joeycastillo/SAMD11_Feathers/OSO-SAFE-A1-04.brd

## EAGLE design OSO-SAFE-A1-04.brd (2023-04-11)

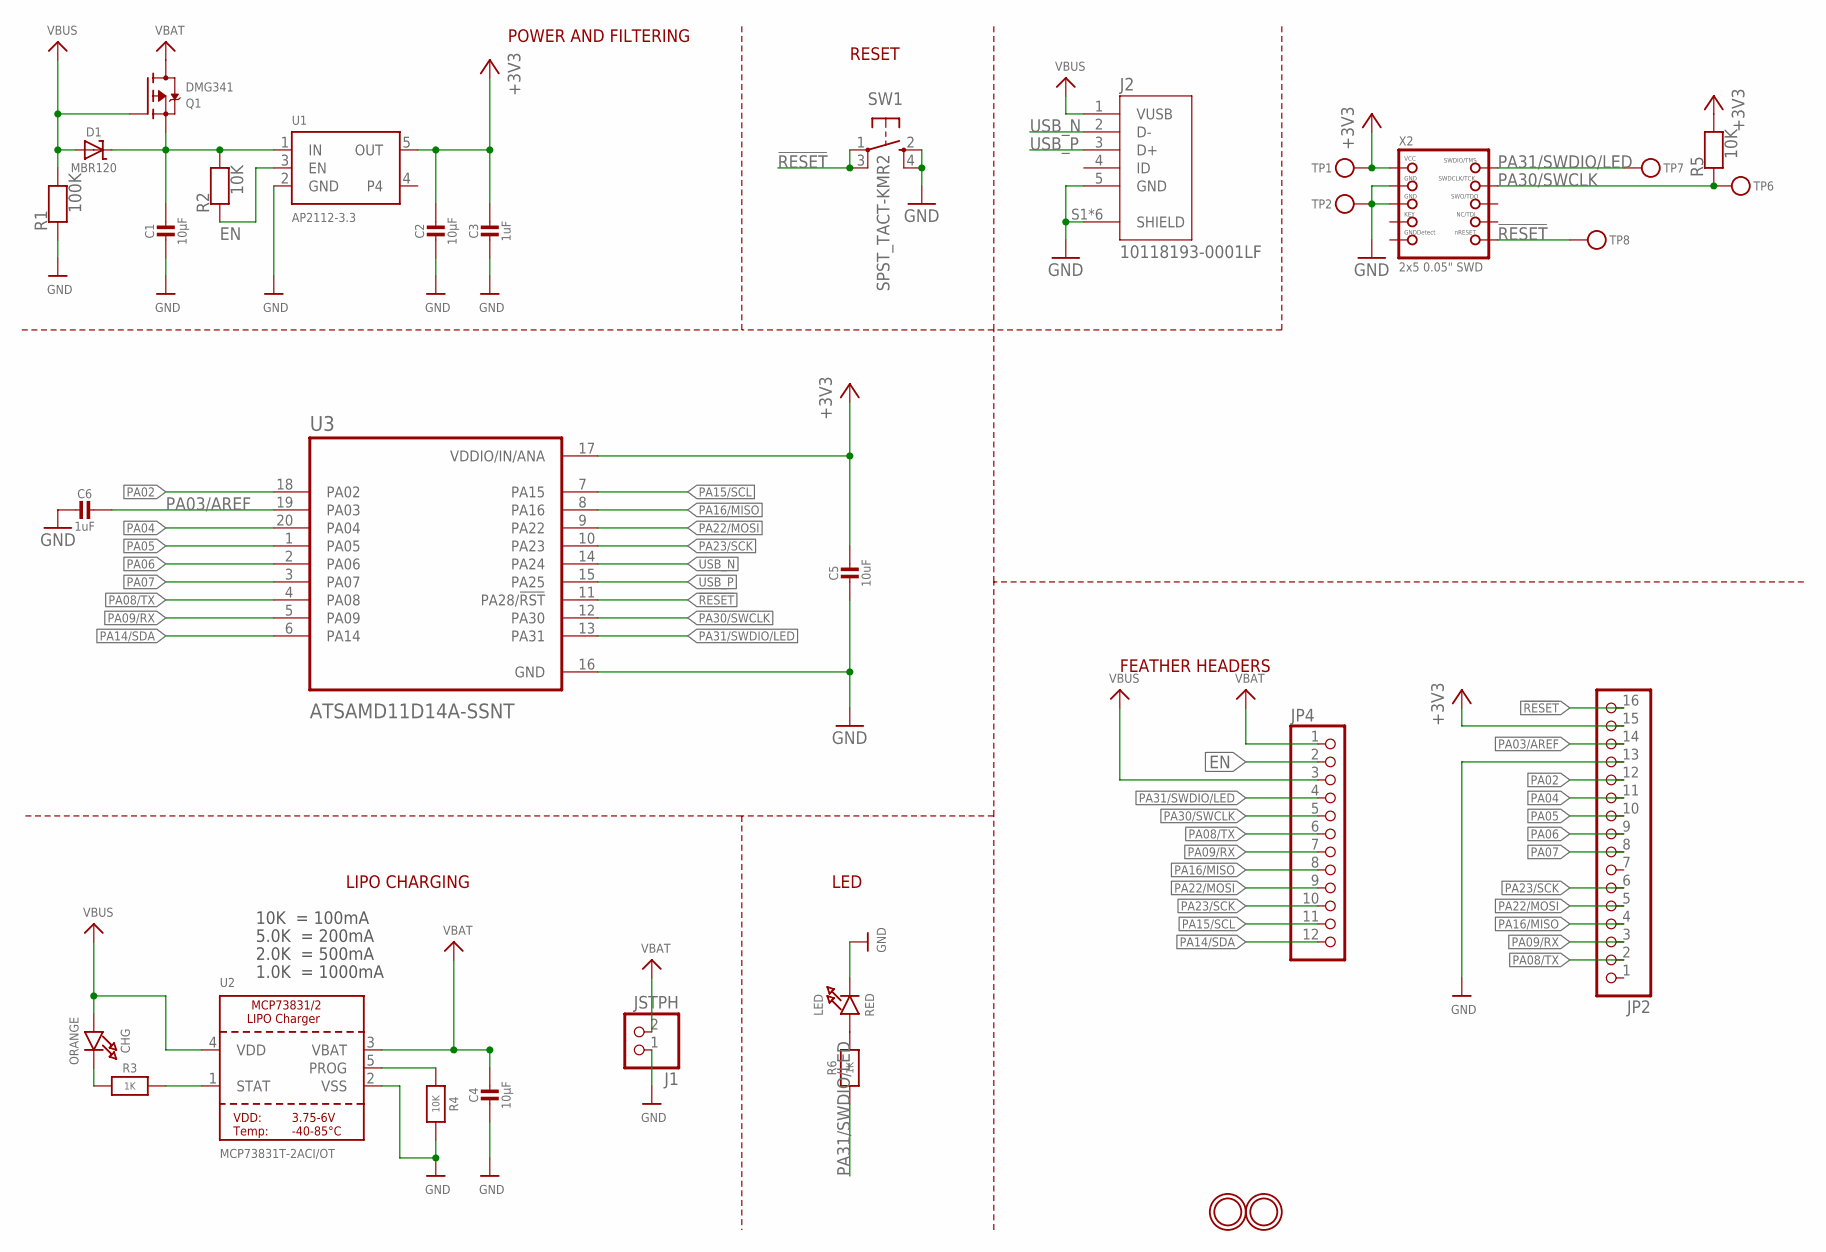
[picture p1: schematic OSO-SAFE-A1-04.sch]

Parts:
C1, C2, C4: 10µF; 0805-NO
C3, C6: 1uF; 0805-NO
C5: 10uF; 0805-NO
CHG: ORANGE; CHIPLED_0805_NOOUTLINE
D1: MBR120; SOD-123
J1: JSTPH; JSTPH2
J2: 10118193-0001LF; FCI_10118193-0001LF
JP2: HEADER-1X16_MIN; 1X16_ROUND_MIN
JP4: HEADER-1X12_MIN; 1X12_ROUND_MIN
LED: RED; CHIPLED_0805_NOOUTLINE
Q1: DMG341; SOT23-R
R1: 100K; 0805-NO
R2, R4, R5: 10K; 0805-NO
R3, R6: 1K; 0805-NO
SW1: SPST_TACT-KMR2; KMR2
TP1, TP2, TP6, TP7, TP8: TESTPOINTROUND2MMNO; TESTPOINT_ROUND_2MM_NO
U1: AP2112-3.3; SOT23-5
U2: MCP73831T-2ACI/OT; SOT23-5
U3: ATSAMD11D14A-SSNT; SOIC127P1030X265-20N
U$31, U$32: MOUNTINGHOLE2.5; MOUNTINGHOLE_2.5_PLATED
X2: 2x5 0.05" SWD; 2X05_1.27MM_BOX_NOPOSTS

Connections:
!RESET: JP2.16, SW1.1, SW1.3 (P1), TP8.P$1, U3.11 (PA28/!RST), X2.10 (NRESET)
+3V3: C2.1, C3.1, C5.1, JP2.15, R5.2, TP1.P$1, U1.5 (OUT), U3.17 (VDDIO/IN/ANA), X2.1 (VCC)
CHG: CHG.C, R3.1
EN: JP4.2, R2.1, U1.3 (EN)
GND: C1.2, C2.2, C3.2, C4.2, C5.2, C6.2, J1.1, J2.5 (GND), J2.S1 (SHIELD), J2.S2 (SHIELD), J2.S3 (SHIELD), J2.S4 (SHIELD), J2.S5 (SHIELD), J2.S6 (SHIELD), JP2.13, LED.C, R1.1, R4.2, SW1.2 (S), SW1.4 (S1), TP2.P$1, U1.2 (GND), U2.2 (VSS), U3.16 (GND), X2.3 (GND), X2.5 (GND)
unnamed: LED.A, R6.2
PA02: JP2.12, U3.18 (PA02)
PA03/AREF: C6.1, JP2.14, U3.19 (PA03)
PA04: JP2.11, U3.20 (PA04)
PA05: JP2.10, U3.1 (PA05)
PA06: JP2.9, U3.2 (PA06)
PA07: JP2.8, U3.3 (PA07)
PA08/TX: JP2.2, JP4.6, U3.4 (PA08)
PA09/RX: JP2.3, JP4.7, U3.5 (PA09)
PA14/SDA: JP4.12, U3.6 (PA14)
PA15/SCL: JP4.11, U3.7 (PA15)
PA16/MISO: JP2.4, JP4.8, U3.8 (PA16)
PA22/MOSI: JP2.5, JP4.9, U3.9 (PA22)
PA23/SCK: JP2.6, JP4.10, U3.10 (PA23)
PA30/SWCLK: JP4.5, R5.1, TP6.P$1, U3.12 (PA30), X2.4 (SWDCLK)
PA31/SWDIO/LED: JP4.4, R6.1, TP7.P$1, U3.13 (PA31), X2.2 (SWDIO)
PROG: R4.1, U2.5 (PROG)
STAT: R3.2, U2.1 (STAT)
USB_N: J2.2 (D-), U3.14 (PA24)
USB_P: J2.3 (D+), U3.15 (PA25)
VBAT: C4.1, J1.2, JP4.1, Q1.3 (D), U2.3 (VBAT)
VBUS: CHG.A, D1.A, J2.1 (VUSB), JP4.3, Q1.1 (G), R1.2, U2.4 (VDD)
VHI: C1.1, D1.C, Q1.2 (S), R2.2, U1.1 (IN)

Notes on the sheet:
LIPO CHARGING
LED
RESET
POWER AND FILTERING
10K = 100mA
5.0K = 200mA
2.0K = 500mA
1.0K = 1000mA
FEATHER HEADERS

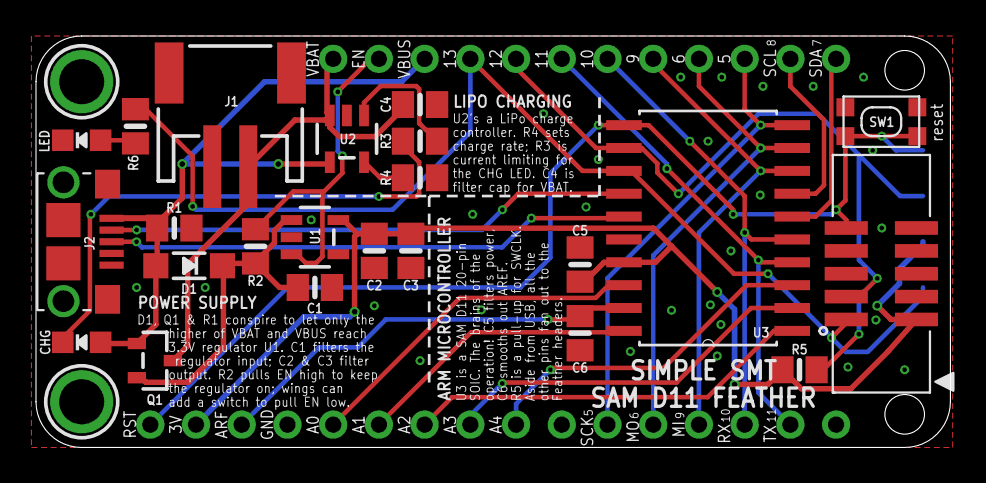
[picture p2: board OSO-SAFE-A1-04.brd from above]

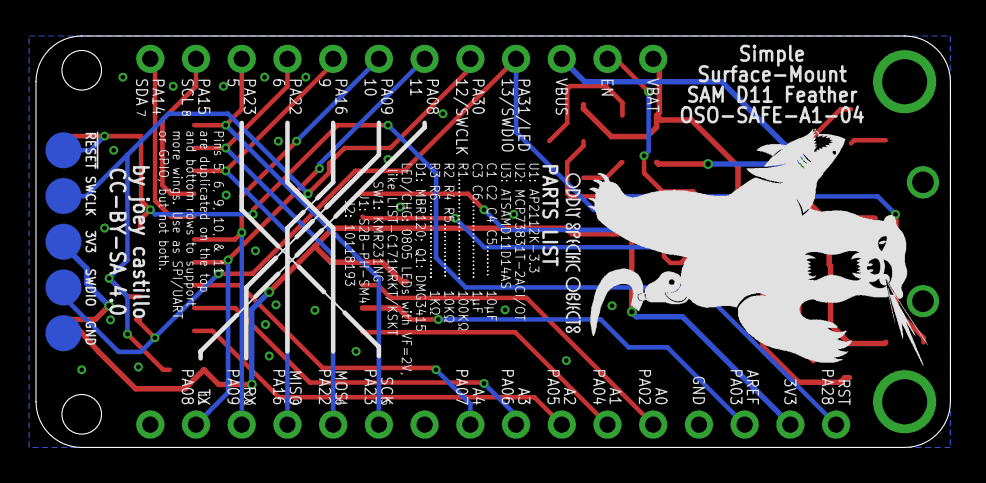
[picture p3: board OSO-SAFE-A1-04.brd from below]

Board: 2 copper layers, 50.8 x 22.9 mm, 34 parts (7 on the bottom side), 28 nets.

Other parts of the board:
U$6: OSO_BEAR_525X750MIL_1000DPI
U$9: OSO_WORDMARK_ONELINE_350MIL_1000DPI
