joeycastillo/SAMD11_Feathers/OSO-SAFE-B1-03.brd

## EAGLE design OSO-SAFE-B1-03.brd (2023-04-11)

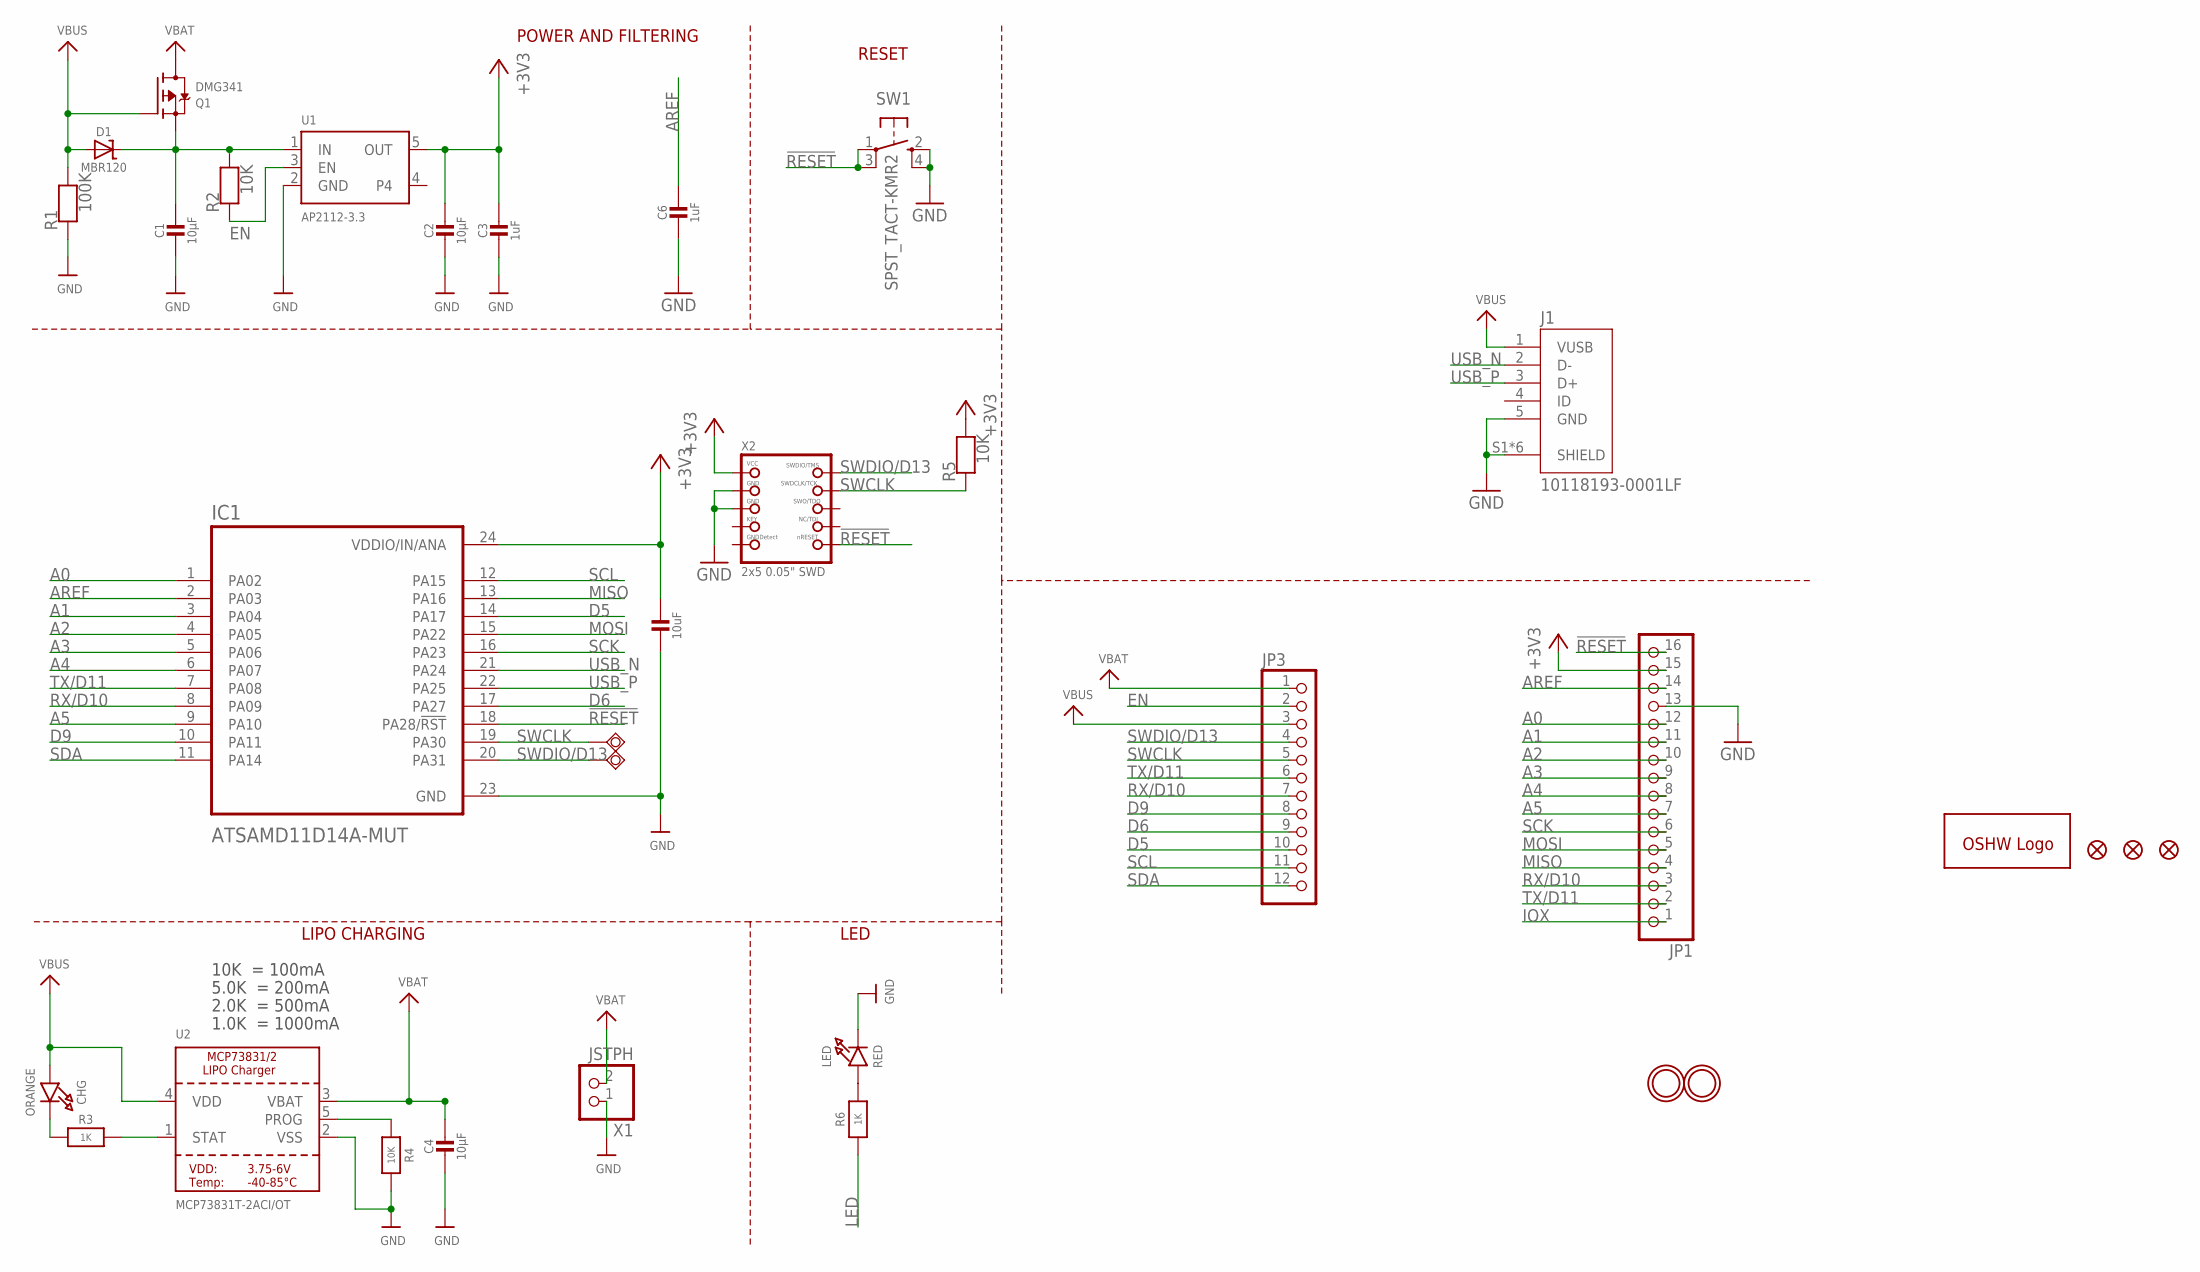
[picture p4: schematic OSO-SAFE-B1-03.sch]

Parts:
C1, C2, C4: 10µF; 0805-NO
C3, C6: 1uF; 0805-NO
C5: 10uF; 0805-NO
CHG: ORANGE; CHIPLED_0805_NOOUTLINE
D1: MBR120; SOD-123
FID1, FID3, FID4: FIDUCIAL_1MM
GOLD_ORB_SM1: OSHWLOGOLOGO5MM; OSHW_5MM
IC1: ATSAMD11D14A-MUT; QFN50P400X400X90-25N
J1: 10118193-0001LF; FCI_10118193-0001LF
JP1: HEADER-1X16_MIN; 1X16_ROUND_MIN
JP3: HEADER-1X12_MIN; 1X12_ROUND_MIN
LED: RED; CHIPLED_0805_NOOUTLINE
Q1: DMG341; SOT23-R
R1: 100K; 0805-NO
R2, R4, R5: 10K; 0805-NO
R3, R6: 1K; 0805-NO
SW1: SPST_TACT-KMR2; KMR2
SWCLK: TPSQTP20R; TP20R
SWDIO: TPSQTP20R; TP20R
U1: AP2112-3.3; SOT23-5
U2: MCP73831T-2ACI/OT; SOT23-5
U$31, U$32: MOUNTINGHOLE2.5; MOUNTINGHOLE_2.5_PLATED
X1: JSTPH; JSTPH2
X2: 2x5 0.05" SWD; 2X05_1.27MM_BOX_POSTS

Connections:
!RESET: IC1.18 (PA28/!RST), JP1.16, SW1.1, SW1.3 (P1), X2.10 (NRESET)
+3V3: C2.1, C3.1, C5.1, IC1.24 (VDDIO/IN/ANA), JP1.15, R5.2, U1.5 (OUT), X2.1 (VCC)
A0: IC1.1 (PA02), JP1.12
A1: IC1.3 (PA04), JP1.11
A2: IC1.4 (PA05), JP1.10
A3: IC1.5 (PA06), JP1.9
A4: IC1.6 (PA07), JP1.8
A5: IC1.9 (PA10), JP1.7
AREF: C6.1, IC1.2 (PA03), JP1.14
CHG: CHG.C, R3.1
D5: IC1.14 (PA17), JP3.10
D6: IC1.17 (PA27), JP3.9
D9: IC1.10 (PA11), JP3.8
EN: JP3.2, R2.1, U1.3 (EN)
GND: C1.2, C2.2, C3.2, C4.2, C5.2, C6.2, IC1.23 (GND), J1.5 (GND), J1.S1 (SHIELD), J1.S2 (SHIELD), J1.S3 (SHIELD), J1.S4 (SHIELD), J1.S5 (SHIELD), J1.S6 (SHIELD), JP1.13, LED.C, R1.1, R4.2, SW1.2 (S), SW1.4 (S1), U1.2 (GND), U2.2 (VSS), X1.1, X2.3 (GND), X2.5 (GND)
IOX: JP1.1
LED: R6.1
MISO: IC1.13 (PA16), JP1.4
MOSI: IC1.15 (PA22), JP1.5
unnamed: LED.A, R6.2
PROG: R4.1, U2.5 (PROG)
RX/D10: IC1.8 (PA09), JP1.3, JP3.7
SCK: IC1.16 (PA23), JP1.6
SCL: IC1.12 (PA15), JP3.11
SDA: IC1.11 (PA14), JP3.12
STAT: R3.2, U2.1 (STAT)
SWCLK: IC1.19 (PA30), JP3.5, R5.1, SWCLK.TP, X2.4 (SWDCLK)
SWDIO/D13: IC1.20 (PA31), JP3.4, SWDIO.TP, X2.2 (SWDIO)
TX/D11: IC1.7 (PA08), JP1.2, JP3.6
USB_N: IC1.21 (PA24), J1.2 (D-)
USB_P: IC1.22 (PA25), J1.3 (D+)
VBAT: C4.1, JP3.1, Q1.3 (D), U2.3 (VBAT), X1.2
VBUS: CHG.A, D1.A, J1.1 (VUSB), JP3.3, Q1.1 (G), R1.2, U2.4 (VDD)
VHI: C1.1, D1.C, Q1.2 (S), R2.2, U1.1 (IN)

Notes on the sheet:
LIPO CHARGING
LED
RESET
POWER AND FILTERING
10K = 100mA
5.0K = 200mA
2.0K = 500mA
1.0K = 1000mA

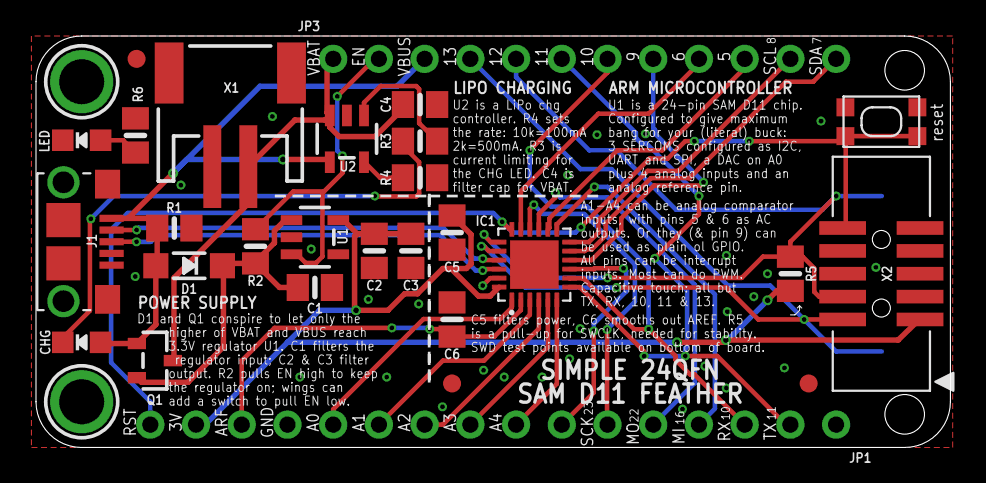
[picture p5: board OSO-SAFE-B1-03.brd from above]

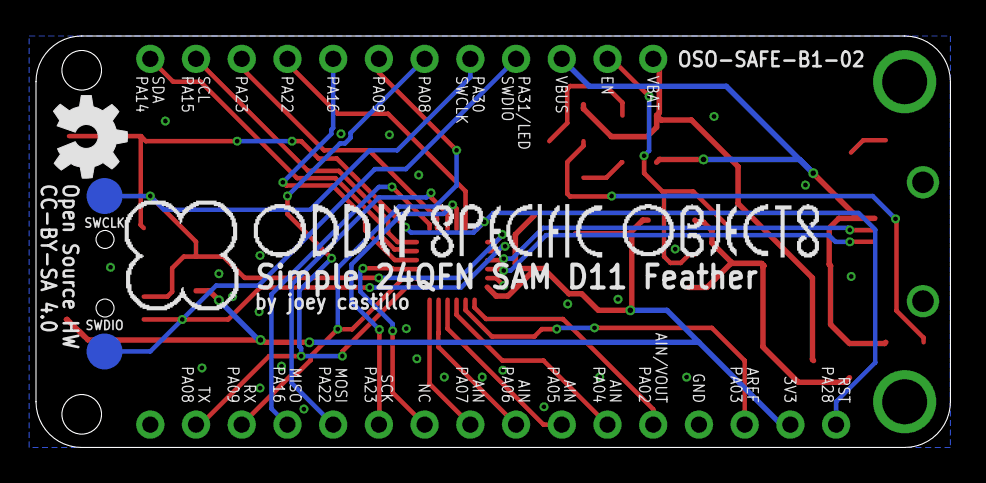
[picture p6: board OSO-SAFE-B1-03.brd from below]

Board: 2 copper layers, 50.8 x 22.9 mm, 36 parts (6 on the bottom side), 32 nets.

Other parts of the board:
U$2: OSO_BEAR; OSO_BEAR_750MIL
U$3: OSO_GRAPHIC
U$5: OSO_TEXTOSO_TEXT_ONELINE_125MIL; OSO_ONELINE_125MIL
