joeycastillo/SAMD11_Feathers/(notices)

Notices in the files:
OSO-SAFE-B1-03.brd:
CC-BY-SA 4.0
parts and their libraries:
microbuilder: This work is placed in the public domain, and may be freely used for commercial and non-commercial work with the following conditions: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
